LeChatduCheshire/Underwater_swarm_project/hardware/drafts/hardware_draft_2.jpeg

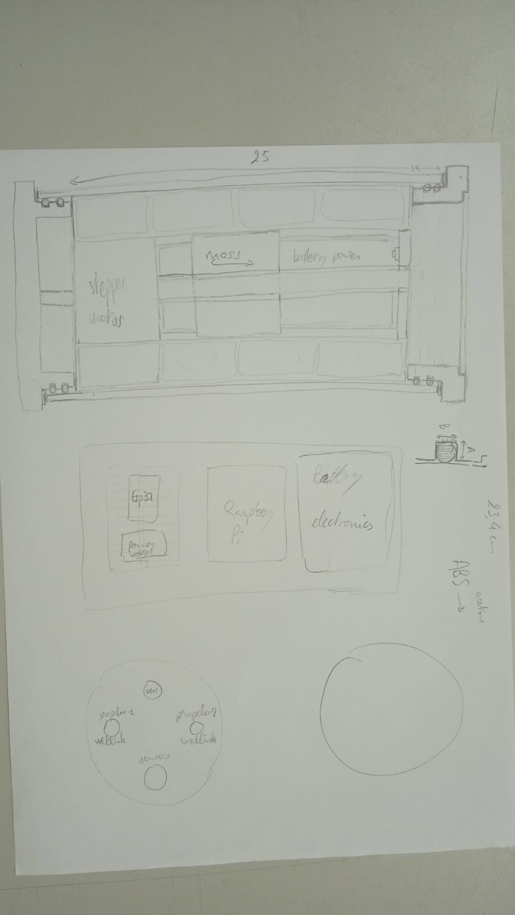
hardware/drafts/hardware_draft_2.jpeg
