LeChatduCheshire/Underwater_swarm_project/hardware/CAD_underwater_swarm_project/stepper_motor_42x48mm/Stepper motor .png

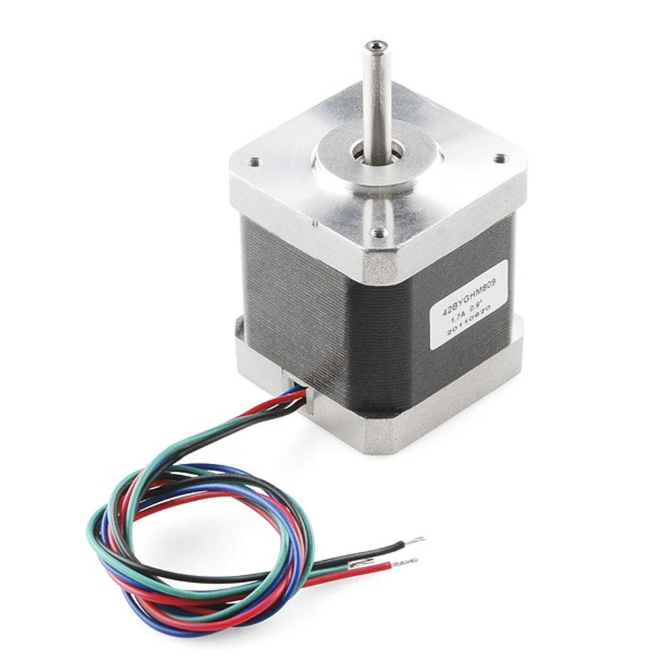
hardware/CAD_underwater_swarm_project/stepper_motor_42x48mm/Stepper motor .png
