LeChatduCheshire/Underwater_swarm_project/README.md

Here are some things to get started with. No rush at all, these are just things to look at over the next couple of weeks.

🎯 Scope
The multi-vehicle formation simulation is part of my ongoing research and upcoming papers, so for this project I'd like us to focus mainly on the real hardware side, building a low-cost ROV and validating it through real-world experiments.

📄 Resources
- My RASSE 2026 and CACS 2026 papers (attached), to understand the background of the project
- ArduSub documentation and ArduPilot SITL docs

🛠 Two things to think about
1. ROV design (especially Thomas, and anyone with mechanical experience)
Could you think about an ROV design that we could realistically build by early November? PVC or 3D printing, either is fine. I'm bringing the thrusters, battery, and electronics, and I'll show you all the parts when I arrive.

2. Research topic (everyone)
Let's think together about a research topic where we can build the ROV and run some experiments by November, and write it up as a paper by your presentation in December. Some examples:
- Design and experimental validation of a low-cost ROV testbed (localization accuracy, position control performance, cost)
- Robust localization for a low-cost ROV, e.g. overhead camera + markers fused with IMU and depth sensor
- System identification of a low-cost ROV to reduce the sim-to-real gap in ArduSub SITL
These are just examples, so feel free to suggest your own ideas!

📅 My schedule
I'll be away from Taiwan from Nov 7 to around Dec 5 for a presentation in Tokyo, the RASSE conference in Chengdu, and an exhibition in Tokyo. I'll be available online by text during that time, so it would be great if we could build the first ROV and do a first pool test before Nov 7.

Also, could you tell me the deadlines for the planning paper, the final paper, and the final presentation (if any)?

💬 By the way, I'm thinking of setting up a Discord server to keep things organized. Would that work for everyone?

When I arrive on October 5, let's meet up, look at the actual parts together, and decide the next steps!
