LeChatduCheshire/Underwater_swarm_project/hardware/Comparring designs.docx

Comparing designs

The general specifications that were followed during the design process of the robot were:

- Robustness against wear
- Watertightness to about 10m
- Unmountability
- Reproductivity without too much adjustment between the different robots
  - This implies that the design must be cheap, to have the budget to make the whole swarm using the same design.

The main differences in price between the safe and the cheap designs come from the hardware, not from the electronics.

The main point is the waterproof hull. Waterproofing is one of the difficult challenges that arise when designing an underwater robot. To function optimally, the joints of the lids must be compressed between grooves of precise dimensions, against an exterior hull which sits at a precise gap of the lid. This requires either precise machining, or a certain amount of work to get the right fitting. The advantage of buying an already-made Bluerobotics hull is that is already done for us, and each product has guaranteed depth resistance of more than 100 meters. For a swarm prototype intended to go to 1- or 2-meters max, these depth limits are completely overkill. The other advantage of using a Bluerobotics hull, is that it is widely used in open-source designs.

Having our own 3D printed design would need more work to get the fitting right for the joints (acetone to get the parts smooth, maybe resin, I am not sure yet). However, I believe that most of the tests and iterations to get the adjustment process right would be done only for the first robot, and then that process would simply be copied for the rest of the swarm. For the whole swarm, it would be a lot cheaper than the bluerobotics option.

Other differences:

Bluerobotics depth sensor vs our depth sensor: The depth sensor we currently have is not waterproof. We need to seal it in epoxy resin in one of the 3D printed part of the robot to allow it to work underwater. This would need to rebuild the support part and rebuy a sensor of something goes wrong, but overall it’s way cheaper than the depth sensor from bluerobotics which is already in a waterproof case.

Vaccum pump: I don’t think having an official model is useful, we can just get a cheap one and an adapter.

Cable penetrators: I think the cheap cable glands are enough for our setting.

For our current project a Raspberry pi 3b will be enough because we don’t have on-board image computing. For Taka’s future projects, he will probably have to upgrade to more recent models.

My conclusion:

If you want to buy the expensive parts for one robot, you have to be ready to do the same for three or four other ones. I would recommend iterating on a low-cost design to make it robust during our project so that the future steps of the swarm project is more accessible.

Comparison of the Two Designs

The robot was designed around the following requirements:

- Resistance to wear and repeated handling.

- Watertightness to approximately 10 meters, although initial experiments will take place at depths of only 1–2 meters.

- Easy disassembly for maintenance and component replacement.

- Reproducibility, with minimal adjustment between individual robots.

- A sufficiently low cost to build an entire swarm using the same design.

The main cost differences between the Safe and Low-cost designs concern the mechanical hardware rather than the electronics.

My Recommendation:

The purchasing decision should be made at the scale of the entire swarm. Choosing expensive components for the first robot implies being prepared to purchase the same components for another three or four robots.

I therefore recommend developing and iterating on the Low-cost design during the current project, with particular attention to sealing reliability, durability and reproducibility. This would require more initial development work, but it should make the next stages of the swarm project more affordable and easier to expand.

Details:

Watertight Enclosure

The enclosure is the most significant difference between the two options. Achieving reliable watertightness is one of the main challenges in underwater robot design. The O-ring grooves, mating surfaces and clearances must be accurately dimensioned to ensure consistent seal compression. This requires either precise manufacturing or additional finishing and adjustment.

A ready-made Blue Robotics enclosure largely removes this development work. Its depth rating depends on the selected configuration, but the available ratings substantially exceed our initial operating depth. Another advantage is that Blue Robotics enclosures are widely used in open-source underwater robotics projects, providing useful design references.

Developing our own enclosure with 3D-printed components would require more work to achieve reliable sealing. Possible finishing methods include acetone smoothing for ABS parts and resin coatings, although the exact process remains to be determined and tested.

I expect most of the development effort to be concentrated on the first prototype. Once the geometry and manufacturing process have been validated, they could be reproduced for the remaining robots. Some individual inspection and adjustment would still be necessary, but this approach should significantly reduce the cost of the complete swarm.

Other Differences

Depth sensor. The sensor we already have is not supplied as a waterproof assembly. We would need to waterproof its electronics and integrate it into a sealed, 3D-printed mount while keeping the pressure-sensing interface functional. Epoxy encapsulation is one possible approach. A failure could require replacing both the sensor and its mount, but the overall cost would remain substantially lower than purchasing a ready-made Blue Robotics depth sensor.

Vacuum pump. I do not see a strong reason to purchase the Blue Robotics pump specifically. A lower-cost manual vacuum pump with a suitable gauge and adapter should be sufficient for our leak tests.

Cable penetrators. Standard cable glands appear to be a reasonable low-cost option for our experimental setting, provided their sealing performance is validated at the intended operating depth.

Onboard computer. A Raspberry Pi 3B should be sufficient for the current project because we do not plan to process images onboard. Taka’s future projects may require a more recent model, depending on their computational requirements.
