LeChatduCheshire/Underwater_swarm_project/hardware/CAD_underwater_swarm_project/underactuated_ROV_technical_drawing_(work_in_progress).png

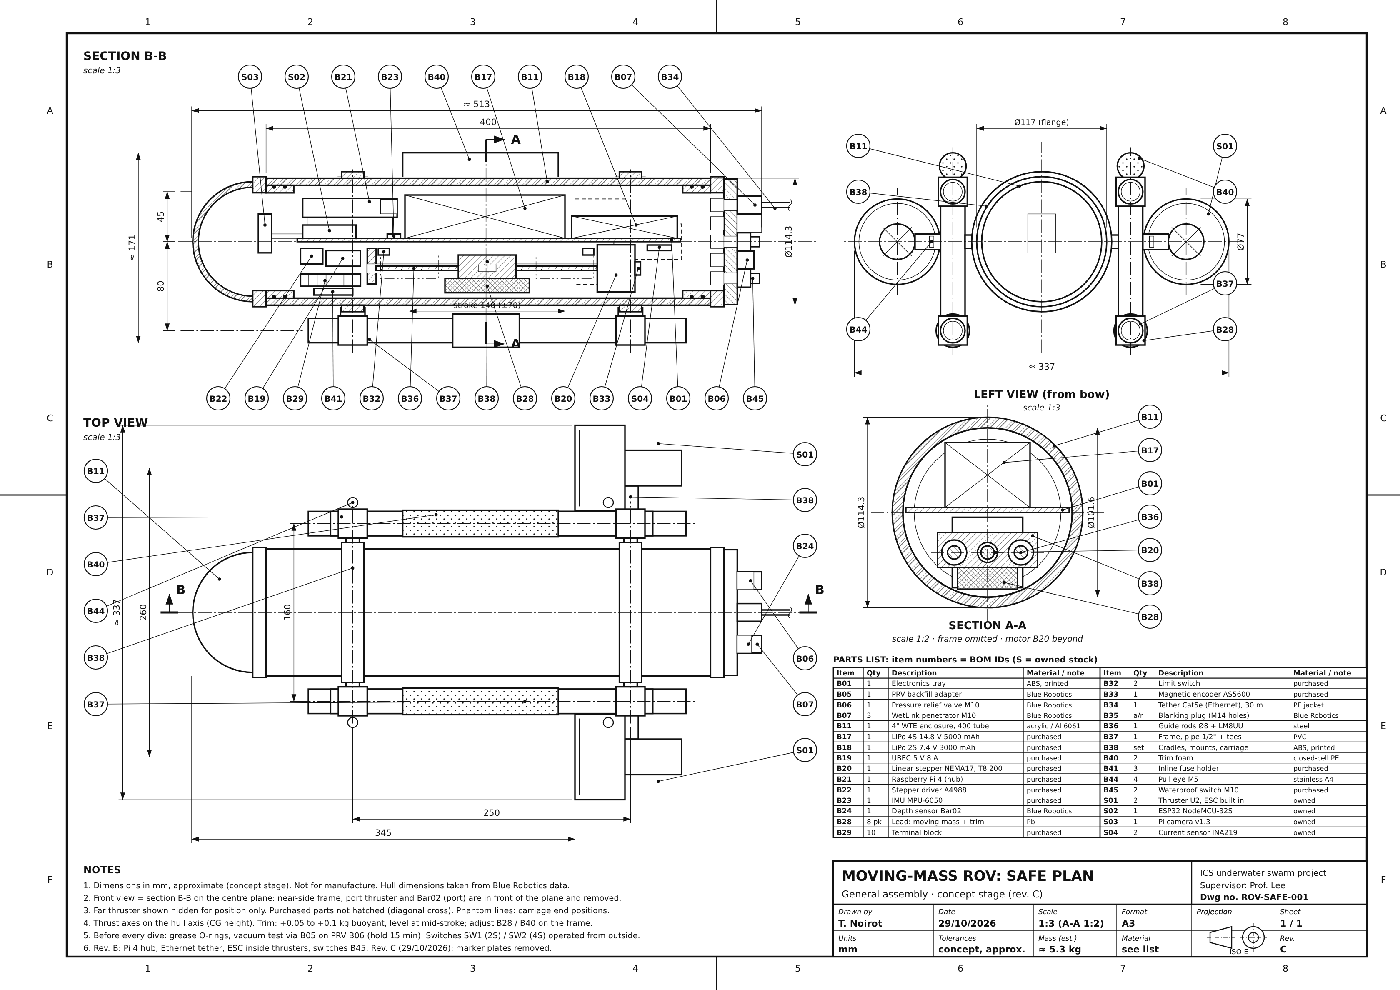
hardware/CAD_underwater_swarm_project/underactuated_ROV_technical_drawing_(work_in_progress).png
