LeChatduCheshire/Underwater_swarm_project/hardware/Doc/stepper_motor_blueprint.png

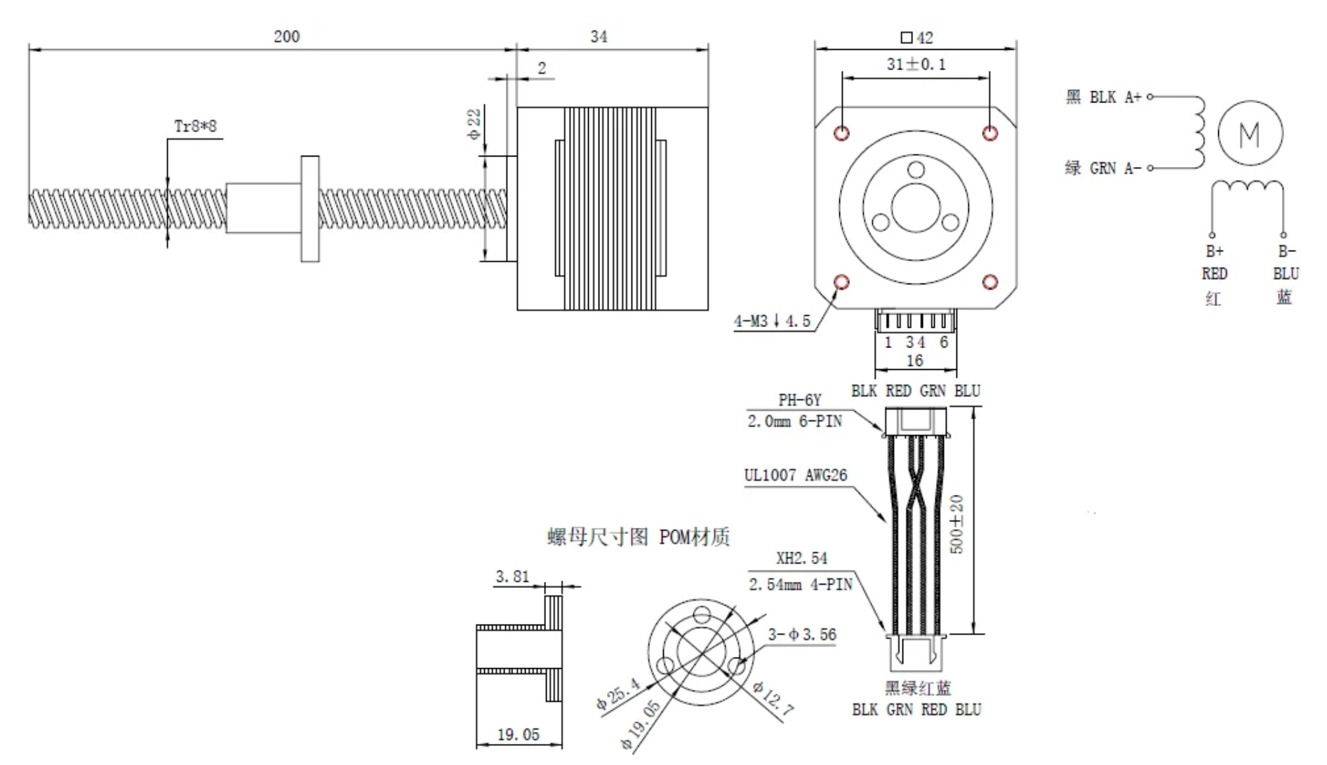
hardware/Doc/stepper_motor_blueprint.png
