LeChatduCheshire/Underwater_swarm_project/hardware/Doc/thruster_blueprint.jpg

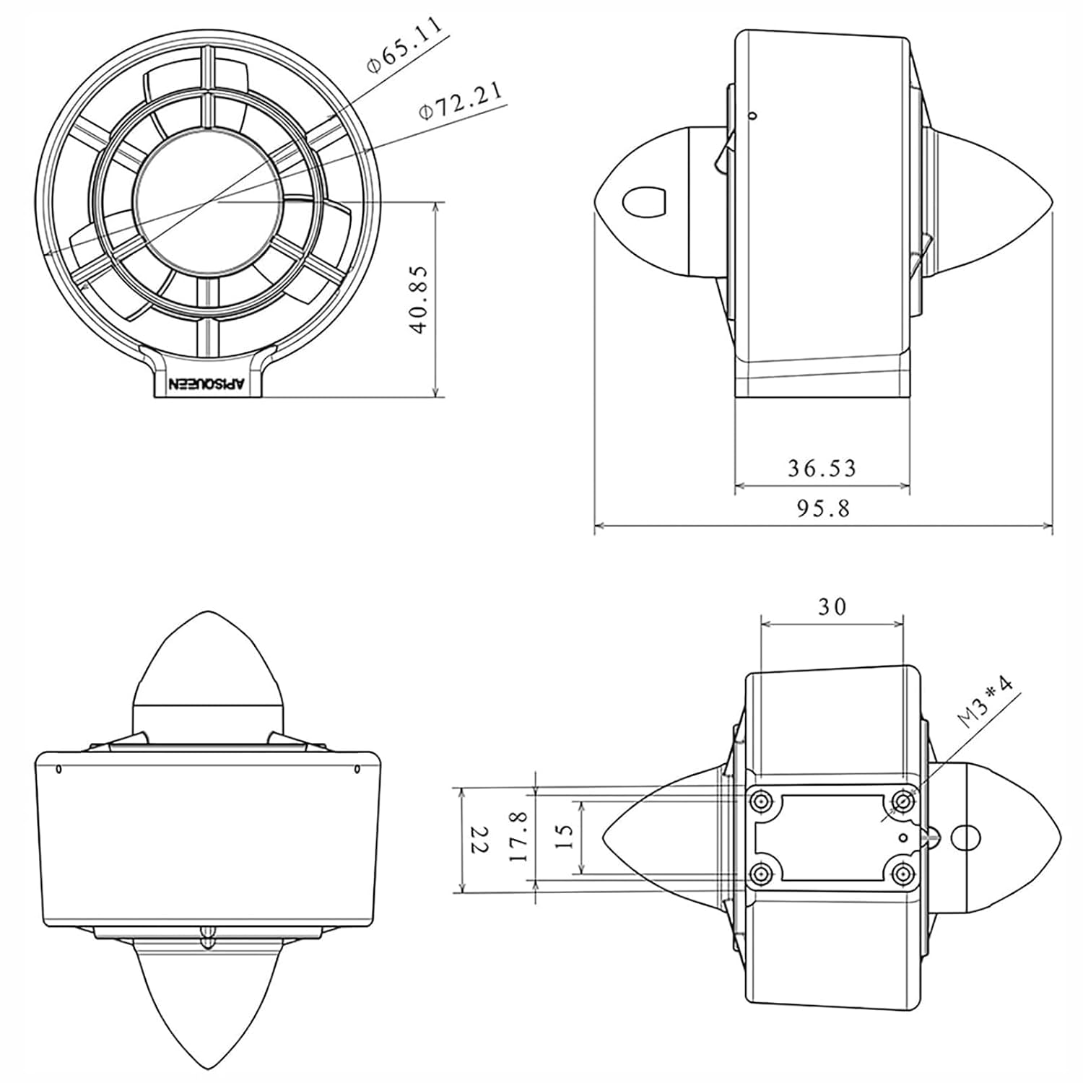
hardware/Doc/thruster_blueprint.jpg
