LeChatduCheshire/Underwater_swarm_project/hardware/drafts/electronics_draft.jpeg

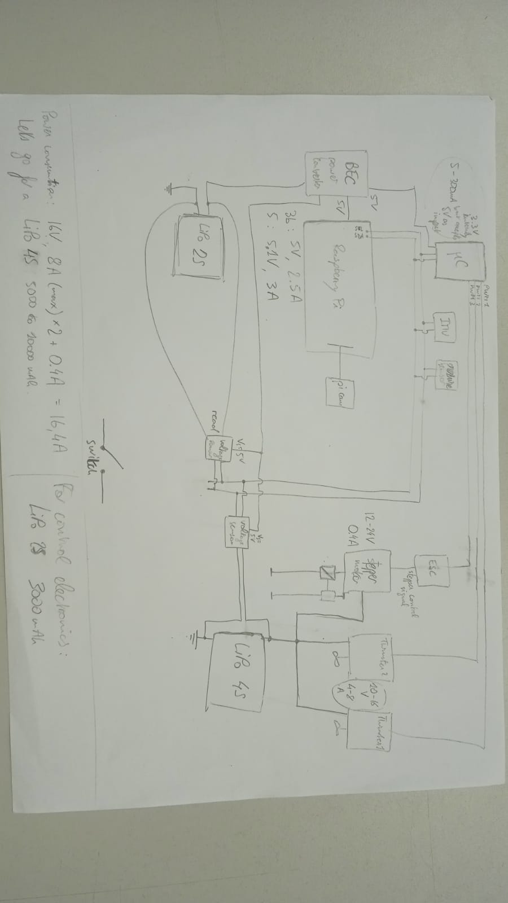
hardware/drafts/electronics_draft.jpeg
