LeChatduCheshire/Underwater_swarm_project/hardware/drafts/hardware_draft_1.jpeg

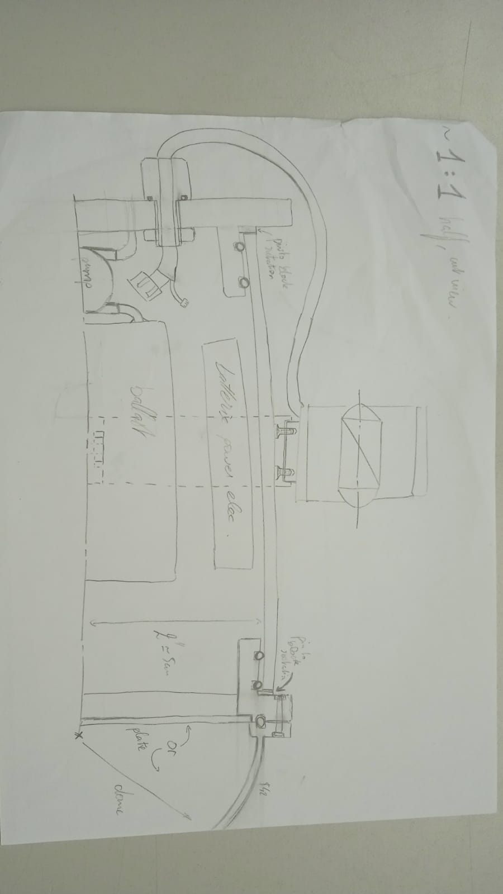
hardware/drafts/hardware_draft_1.jpeg
