LeChatduCheshire/Underwater_swarm_project/hardware/Electronics/underactuated_ROV_electronics_diagram.png

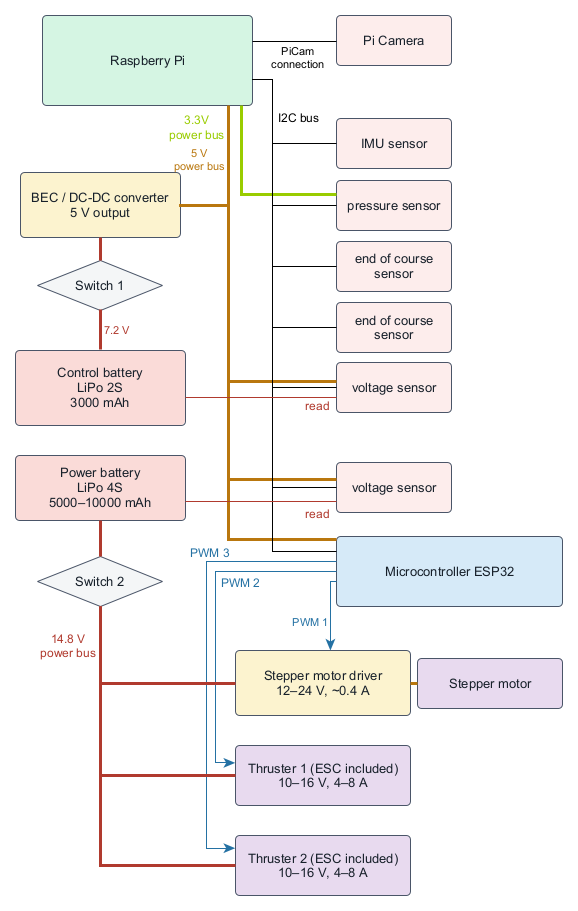
hardware/Electronics/underactuated_ROV_electronics_diagram.png
