LeChatduCheshire/Underwater_swarm_project/hardware/Underwater_Swarm_BOM_TWD_2026.10.19.xlsx

Sheet: Summary
Underwater swarm BOM and purchase tracker
19 October 2026 (Taiwan) | One prototype plus shared tools and consumables | Amounts in TWD
USD to TWD | Reference rate | 32.334 | 18 Oct reference; bank/card rates may differ.
Option | Robot items | Shared items | Budget total | Spent | Still to spend
Safe | 28659.82 | 3768.73 | 32428.55 | 1068.00 | 31240.55
Low-cost | 9458.88 | 2545.67 | 12004.55 | 1068.00 | 10816.55
How to use
Open Parts and filter Option to Both plus the design you choose.
Change Bought? from No to Yes. Remaining drops to zero for that line.
Enter Actual paid TWD for a purchased line, or leave blank to use its budget cost.
For a partial purchase, split the line into separate bought/unbought quantities before checking it.
Both options are alternatives. Spent for a common part appears in each option, not as two purchases.
Budget total is the original plan at current inputs. Spent + remaining may differ after actual-price overrides.
No shipping, customs or payment fees are included. Add those to actual paid costs when known.
Prices marked Sheet quote are copied from the updated sheet and have not all been reverified.
Hypotheses identify estimated prices, selected variants, assumed quantities or undefined interfaces.
Print labor and machine access assumed free. A whole ABS spool is included as a cash purchase.
Complete Safe enclosure assumed to include caps, flanges and installed seals. Confirm configuration.
Backfill adapter and epoxy remain conditional. Set their buy quantity to 0 if you omit them.
Excluded existing stock | Quantity | Applies to
Silicone grease | 1 | Both
Mean Well RSP-320-15 supply | 1 | Both
Fuses (required total still TBD) | 2 | Both
Zegtai 1221 switch | 1 | Both
Apisqueen U2-45A thrusters | 4 | Both
Raspberry Pi 3B | 1 | Low-cost
ESP32 NodeMCU-32S | 1 | Both
Pi camera rev 1.3 | 1 | Both
INA219 current sensor | 2 | Both
MS5837 pressure sensor | 1 | Low-cost
Removed red rows: flexible ballast tank (3), ballast pump head (4), DC pump motor (26).
Safe vacuum plug included in pump kit. Safe enclosure components not counted again.
Online source
https://docs.google.com/spreadsheets/d/1nn8rRRaJWsULoW_6BYai7hUYHaue34ss3Joc6yCNnSo/edit?usp=sharing
FX reference
https://exchangeratetool.com/usd-to-twd

Sheet: Parts
Underwater robot purchase BOM
For one prototype. Both = common to either option. Alternative options must not be added together.
Set Bought? to Yes after purchasing the whole line. Enter actual line cost in TWD if it differs. Yellow cells are editable.
ID | Option | Part | Reference / model | Scope | Bought? | Buy qty | Purchase unit | Unit price | Currency | Unit TWD | Budget TWD | Actual paid TWD | Spent TWD | Remaining TWD | Price basis | Source row | Supplier / source URL | Assumptions / notes
B01 | Both | Internal electronics support | Custom 3D print | Robot | No | 1 | assembly | 0.00 | TWD | 0.00 | 0.00 |  | 0.00 | 0.00 | Workshop assumption | BOM row 5 | https://docs.google.com/spreadsheets/d/1nn8rRRaJWsULoW_6BYai7hUYHaue34ss3Joc6yCNnSo/edit?usp=sharing | Source lists zero. Printing labor/machine access assumed free; one shared filament spool budgeted separately.
B02 | Safe | Vacuum pump kit | Blue Robotics Mityvac BR-100297 | Shared | No | 1 | kit | 98.00 | USD | 3168.73 | 3168.73 |  | 0.00 | 3168.73 | Sheet quote | BOM row 6 | https://bluerobotics.com/store/watertight-enclosures/enclosure-tools-supplies/vacuum-pump-kit-r2-rp/ | Includes hose and vacuum plug. One kit for all robots.
B03 | Low-cost | Manual vacuum pump | Ruten 22635510427265 | Shared | No | 1 | kit | 1123.00 | TWD | 1123.00 | 1123.00 |  | 0.00 | 1123.00 | Sheet quote | BOM row 6 | https://www.ruten.com.tw/item/22635510427265/ | Verify hose fit with Blue Robotics plug.
B04 | Low-cost | Vacuum test plug | Blue Robotics BR-101118 | Shared | No | 1 | piece | 8.00 | USD | 258.67 | 258.67 |  | 0.00 | 258.67 | Sheet quote | BOM row 7 | https://bluerobotics.com/store/watertight-enclosures/enclosure-tools-supplies/vacuum-plug/ | Safe option already includes this plug.
B05 | Both | PRV backfill adapter | Blue Robotics BR-100490 | Robot | No | 1 | piece | 13.00 | USD | 420.34 | 420.34 |  | 0.00 | 420.34 | Sheet quote / optional | BOM row 8 | https://bluerobotics.com/store/watertight-enclosures/prv-m10-backfill-adapter/ | Optional but retained as listed. Set quantity to 0 if not wanted.
B06 | Both | Pressure relief valve | Blue Robotics BR-100804 | Robot | No | 1 | piece | 32.00 | USD | 1034.69 | 1034.69 |  | 0.00 | 1034.69 | Sheet quote | BOM row 9 | https://bluerobotics.com/store/watertight-enclosures/enclosure-tools-supplies/prv-m10-asm/ | Blank low-cost alternative interpreted as same common part.
B07 | Safe | Cable penetrators | WetLink WLP-VP; size TBD | Robot | No | 3 | piece | 15.00 | USD | 485.01 | 1455.03 |  | 0.00 | 1455.03 | Hypothesis: range midpoint | BOM row 10 | https://bluerobotics.com/store/cables-connectors/penetrators/wlp-vp/ | 3 minimum from sheet. USD15 midpoint of USD13–17. Select cable diameter and seal size.
B08 | Low-cost | Cable glands | QILIPSU; exact thread/cable size TBD | Robot | No | 1 | 10-pack | 324.23 | TWD | 324.23 | 324.23 |  | 0.00 | 324.23 | Sheet quote | BOM row 10 | https://www.amazon.com/dp/B0F99Q364K | Buy one full pack of 10, not 3/10 of a pack. At least 3 glands needed.
B09 | Low-cost | Waterproof epoxy | Two-part waterproof epoxy; grade TBD | Shared | No | 1 | tube | 350.00 | TWD | 350.00 | 350.00 |  | 0.00 | 350.00 | Hypothesis: range midpoint | BOM row 12 | https://www.amazon.com/dp/B00R2CDVIW | Midpoint of sheet TWD200–500. Conditional on flat panel; set quantity to 0 for dome.
B10 | Low-cost | ABS finishing solvent | Union Chemical UCW-80343 acetone 99.5% | Shared | No | 1 | 500 mL bottle | 214.00 | TWD | 214.00 | 214.00 |  | 0.00 | 214.00 | Web price / size hypothesis | BOM row 13 | https://www.kingtec.com.tw/product/acetone/ | Assume one 500 mL bottle for prototype. ABS finishing does not establish pressure tightness.
B11 | Safe | Complete 4-inch enclosure | Blue Robotics WTE-VP configuration TBD | Robot | No | 1 | assembly | 440.00 | USD | 14226.96 | 14226.96 |  | 0.00 | 14226.96 | Sheet quote / configuration hypothesis | BOM row 14 | https://bluerobotics.com/store/watertight-enclosures/wte-vp/ | Use USD440 from updated sheet. Assume includes tube, both end caps, flanges and installed O-rings. Exact configuration referenced on Discord was not supplied.
B12 | Low-cost | PVC hull tube | MECCANIXITY 4-inch class, approx. 13-inch long | Robot | No | 1 | tube | 596.86 | TWD | 596.86 | 596.86 |  | 0.00 | 596.86 | Sheet quote | BOM row 14 | https://www.amazon.com/dp/B09J14MMVD | Dimensions/wall thickness must match CAD; local pipe may cost less.
B13 | Low-cost | Front end cap | ABS custom 3D print | Robot | No | 1 | piece | 0.00 | TWD | 0.00 | 0.00 |  | 0.00 | 0.00 | Workshop assumption | BOM row 15 | https://docs.google.com/spreadsheets/d/1nn8rRRaJWsULoW_6BYai7hUYHaue34ss3Joc6yCNnSo/edit?usp=sharing | Filament budgeted separately. Labor/machine access assumed free.
B14 | Low-cost | Rear end cap | ABS custom 3D print | Robot | No | 1 | piece | 0.00 | TWD | 0.00 | 0.00 |  | 0.00 | 0.00 | Workshop assumption | BOM row 16 | https://docs.google.com/spreadsheets/d/1nn8rRRaJWsULoW_6BYai7hUYHaue34ss3Joc6yCNnSo/edit?usp=sharing | Filament budgeted separately. Labor/machine access assumed free.
B15 | Low-cost | Enclosure O-ring sets | Blue Robotics spare O-ring set, 4-inch variant TBD | Robot | No | 2 | set | 10.00 | USD | 323.34 | 646.68 |  | 0.00 | 646.68 | Sheet approximate price | BOM row 17 | https://bluerobotics.com/store/watertight-enclosures/locking-series/spare-o-ring-set/ | Two sets as requested in sheet. Confirm actual contents include required rings/spares.
B16 | Low-cost | Watertight junction parts | ABS custom 3D print | Robot | No | 2 | piece | 0.00 | TWD | 0.00 | 0.00 |  | 0.00 | 0.00 | Workshop assumption | BOM row 18 | https://docs.google.com/spreadsheets/d/1nn8rRRaJWsULoW_6BYai7hUYHaue34ss3Joc6yCNnSo/edit?usp=sharing | Geometry TBD. Filament budgeted separately.
B17 | Both | Propulsion battery | GNB 4S 14.8V 5000mAh 60C | Robot | No | 1 | pack | 2490.00 | TWD | 2490.00 | 2490.00 |  | 0.00 | 2490.00 | Hypothesis: variant price | BOM row 19 | https://www.ruten.com.tw/item/22424717617261/ | Listing spans TWD1380–2490 across 2S/3S/4S. Use upper value for 4S; exact variant price/connector must be confirmed.
B18 | Both | Control battery | Yingke 2S 7.4V 3000mAh 5C | Robot | No | 1 | pack | 820.00 | TWD | 820.00 | 820.00 |  | 0.00 | 820.00 | Web price / model hypothesis | BOM row 20 | https://www.ruten.com.tw/item/22538957862265/ | Assumed model for requested capacity. Confirm dimensions, connector and control-side current.
B19 | Both | 5V voltage converter | ZTW UBEC 8A G2 | Robot | No | 1 | piece | 634.00 | TWD | 634.00 | 634.00 |  | 0.00 | 634.00 | Sheet quote / quantity hypothesis | BOM row 22 | https://www.amazon.com/dp/B0CMD126S4 | Assume one converter; source quantity blank. Set output to 5V and verify full control load.
B20 | Both | Moving-weight linear stepper | NEMA17, 34mm stack, 8mm lead, 200mm screw | Robot | No | 1 | assembly | 40.00 | USD | 1293.36 | 1293.36 |  | 0.00 | 1293.36 | Sheet quote | BOM row 25 | https://www.frankhuai.com/nema-17-lead-screw-stepper-motor-34mm-linear | Retained new depth-control mechanism. Nut/carriage/guides and travel stops need CAD confirmation.
B21 | Safe | Single-board computer | Raspberry Pi 4 Model B 4GB | Robot | No | 1 | board | 2500.00 | TWD | 2500.00 | 2500.00 |  | 0.00 | 2500.00 | Hypothesis: model and price | BOM row 28 | https://shop.mirotek.com.tw/shop/200056/ | Choose Pi4 4GB from sheet Pi4/5. TWD2500 planning estimate against local TWD2310–7680 listing; reference seller shows sold out. Low-cost uses owned Pi3B.
B22 | Both | Stepper motor driver | A4988 module / listed HiLetgo pack | Robot | No | 1 | listed pack | 330.72 | TWD | 330.72 | 330.72 |  | 0.00 | 330.72 | Sheet quote / pack hypothesis | BOM row 29 | https://www.amazon.com/dp/B07BND65C8 | Retain full listing price; package count not confirmed. One driver required.
B23 | Both | IMU | MPU-6050 GY-521; 100Y item 95753 | Robot | No | 1 | module | 120.00 | TWD | 120.00 | 120.00 |  | 0.00 | 120.00 | Web price | BOM row 33 | https://www.100y.com.tw/product/95753 | Taiwan retailer lists TWD120; matches required MPU6050.
B24 | Safe | Depth/pressure sensor | Blue Robotics Bar sensor; pressure range TBD | Robot | No | 1 | module | 80.00 | USD | 2586.72 | 2586.72 |  | 0.00 | 2586.72 | Sheet quote | BOM row 34 | https://bluerobotics.com/store/sensors-cameras/sensors/bar-depth-pressure-sensor/ | Low-cost uses existing MS5837. Select pressure range before buying.
B25 | Both | USB to RS485 adapter | USB-RS485; iCShop 368110900069 as benchmark | Robot | Yes | 1 | adapter | 100.00 | TWD | 100.00 | 100.00 |  | 100.00 | 0.00 | Hypothesis: model, quantity, allowance | BOM row 35 | https://www.icshop.com.tw/ms/products/368110900069 | Source names CP2102, which is USB-UART, not RS485. Allow TWD100 for true RS485; TWD39 benchmark listing is sold out. Confirm intended interface.
B26 | Both | Unspecified USB interface | Provisional CP2102 USB-UART; iCShop 368030501364 | Robot | Yes | 1 | adapter | 58.00 | TWD | 58.00 | 58.00 |  | 58.00 | 0.00 | Hypothesis: function and quantity | BOM row 36 | https://www.icshop.com.tw/products/368030501364 | Source says USB to something and links a TI paper, not a product. Placeholder only, not a confirmed requirement. Set quantity 0 if duplicate.
B27 | Both | Wiring and connectors | Prototype wiring lot; gauges/connectors TBD | Robot | Yes | 1 | lot | 250.00 | TWD | 250.00 | 250.00 |  | 250.00 | 0.00 | Hypothesis: lot content and price | BOM row 37 | https://www.ruten.com.tw/item/21729730427431/ | Allow TWD250 for mixed wire/connectors/heat-shrink. Local 18AWG benchmark is TWD13/m. Final propulsion gauge depends on current.
B28 | Both | Lead trim / moving weight | Adhesive lead strips, 2 x 60g per pack | Robot | No | 4 | 120g pack | 40.00 | TWD | 40.00 | 160.00 |  | 0.00 | 160.00 | Hypothesis: required mass | BOM row 38 | https://www.ruten.com.tw/item/21904699547905/ | Assume 480g starting allowance, NOT validated depth-control mass. Retained non-red lead row; trim and moving-weight material only.
B29 | Both | Terminal blocks | Small screw/lever terminal connectors | Robot | Yes | 10 | piece | 6.00 | TWD | 6.00 | 60.00 |  | 60.00 | 0.00 | Hypothesis: type and quantity | BOM row 39 | https://www.goldsafety.com.tw/products/%E6%8E%A5%E7%B7%9A%E7%AB%AF%E5%AD%90-%E5%BF%AB%E9%80%9F%E6%8E%A5%E9%A0%AD | Assume 10 pieces at local TWD6 benchmark. Match current rating and wire size.
B30 | Both | 3D printing material | ONION3D ABS original, 1kg spool | Shared | Yes | 1 | spool | 600.00 | TWD | 600.00 | 600.00 |  | 600.00 | 0.00 | Hypothesis: material requirement | Added estimate | https://www.onion3d.com/products/abs-original | One spool assumed enough for one prototype. Covers printed supports, caps and junctions; avoids treating material as free.
B31 | Both | End of course sensors for the mass shift system | Limit Switches | Robot | No | 2 | piece | 60.00 | TWD | 60.00 | 120.00 |  | 0.00 | 120.00 | Web site | added after | https://www.100y.com.tw/product/72384 | Pack of 2 for 120 TWD
