LeChatduCheshire/Underwater_swarm_project/hardware/Underwater_Swarm_BOM_TWD_2026.10.10.xlsx

Sheet: Cost comparison
Underwater swarm prototype — purchase costs
Price check date | 2026-10-07 |  | Bank of Taiwan spot selling rate, quoted 2026-10-07 16:40 Taipei.
USD to TWD | 31.875 |  | https://rate.bot.com.tw/xrt?Lang=en-US
Fleet size | 1 |  | Fleet size scales new purchases; existing stock is excluded and is not allocated to extra robots.
Design option | Robot low (TWD) | Robot high (TWD) | Shared low (TWD) | Shared high (TWD)
Safe design | 3043.14 | 3298.14 | 3123.75 | 3123.75
Low-cost design | 2414.38 | 2714.38 | 1378.00 | 1378.00
Priced subtotal for fleet | Low (TWD) | High (TWD)
Safe design | 6166.89 | 6421.89
Low-cost design | 3792.38 | 4092.38
These are partial subtotals, not complete robot budgets.
Shipping, import charges and payment FX fees are excluded. USD prices are converted estimates in TWD.
Includes unverified NKP sheet quote, minimum 2 WetLink penetrators and conditional epoxy range.
Excluded existing stock
Item / reference | Available quantity | Exclusion
Silicone grease | 1 | Both options
Mean Well RSP-320-15 | 1 | Both options
Fuses | 2 | Both options; required total unknown
Zegtai switch 1221 | 1 | Both options
Apisqueen U2-45A thrusters | 4 | Both options
Raspberry Pi 3B | 1 | Low-cost option only
ESP32 NodeMCU-32S | 1 | Both options
Raspberry Pi camera rev 1.3 | 1 | Both options
INA219 current sensor modules | 2 | Both options
MS5837 pressure sensor | 1 | Both options
Source workbook
https://docs.google.com/spreadsheets/d/1nn8rRRaJWsULoW_6BYai7hUYHaue34ss3Joc6yCNnSo/edit?gid=2086489133
No new models were invented for unspecified batteries, hull parts, motors, converters or wiring.

Sheet: Safe design
Safe design — purchase BOM
Scope: one prototype + shared equipment. Already-owned components excluded.
Blank low-cost entries use the safe option unless a distinct alternative is listed.
Subtotal excludes sold-out item and unpriced lines. Built parts have no material/labor estimate.
Source row | Subsystem | Item | Reference / model | Scope | Qty | Currency | Unit low | Unit high | Unit low (TWD) | Unit high (TWD) | Line low (TWD) | Line high (TWD) | Price status | Supplier / source URL | Notes
3 | Hardware | Flexible ballast tank | Thunder Tiger PJ6110 | Per robot | 1 | USD | 6.99 | 6.99 | 222.81 | 222.81 |  |  | Sold out / historical | https://shop.thundertiger.com/en-hz/products/thunder-tiger-neptune-sb-1-seawolf-oceanmaster-ballast-tank-pj6110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 | Listed as sold out. Historical price only; excluded from purchasable subtotal.
4 | Hardware | Ballast pump head | Kamoer NKP pump head; listing 1005008777458190 | Per robot | 1 | TWD | 660.00 | 660.00 | 660.00 | 660.00 | 660.00 | 660.00 | Sheet quote, unverified | https://www.aliexpress.com/item/1005008777458190.html?utm_source=chatgpt.com | Sheet quote only, not independently verified. Motor excluded; tubing variant must be selected.
5 | Hardware | Internal electronics support | Not selected | Per robot | 1 | TWD |  |  |  |  |  |  | Build cost not estimated | https://docs.google.com/spreadsheets/d/1nn8rRRaJWsULoW_6BYai7hUYHaue34ss3Joc6yCNnSo/edit?gid=2086489133 | Source budget is zero. Printing materials and labor are uncosted, not assumed free.
6 | Hardware | Hand-operated vacuum pump | Blue Robotics BR-100297 | Shared equipment | 1 | USD | 98.00 | 98.00 | 3123.75 | 3123.75 | 3123.75 | 3123.75 | Verified USD list price | https://bluerobotics.com/store/watertight-enclosures/enclosure-tools-supplies/vacuum-pump-kit-r2-rp/ | Includes hose and vacuum plug. One kit shared across fleet.
7 | Hardware | Vacuum test plug | Blue Robotics BR-101118 | Shared equipment | 0 | USD | 8.00 | 8.00 | 255.00 | 255.00 | 0.00 | 0.00 | Included in pump kit | https://bluerobotics.com/store/watertight-enclosures/enclosure-tools-supplies/vacuum-plug/ | No separate purchase: included in BR-100297 kit.
8 | Hardware | PRV backfill adapter | Blue Robotics BR-100490 | Per robot | 1 | USD | 13.00 | 13.00 | 414.38 | 414.38 | 414.38 | 414.38 | Verified USD list price | https://bluerobotics.com/store/watertight-enclosures/prv-m10-backfill-adapter/ | Optional in source; retained in priced subtotal. Source quantity is one per robot.
9 | Hardware | Pressure relief valve | Blue Robotics BR-100804 | Per robot | 1 | USD | 32.00 | 32.00 | 1020.00 | 1020.00 | 1020.00 | 1020.00 | Verified USD list price | https://bluerobotics.com/store/watertight-enclosures/enclosure-tools-supplies/prv-m10-asm/ | Retained as listed. Low-cost column has no explicit alternative.
10 | Hardware | Cable penetrators | Blue Robotics WLP-VP; size not selected | Per robot | 2 | USD | 13.00 | 17.00 | 414.38 | 541.88 | 828.76 | 1083.76 | Verified product-family range | https://bluerobotics.com/store/cables-connectors/penetrators/wlp-vp/ | Minimum quantity 2 assumed. Exact thread, cable diameter and total penetrator count remain open.
13 | Hardware | Plastic finishing solvent | Official product | Per robot | 1 | TWD |  |  |  |  |  |  | Missing specification / price | https://docs.google.com/spreadsheets/d/1nn8rRRaJWsULoW_6BYai7hUYHaue34ss3Joc6yCNnSo/edit?gid=2086489133 | Exact solvent and print material unspecified.
14 | Hardware | Main tubular hull, 4-inch class | Acrilic tube (BlueRobotics) | Per robot | 1 | TWD |  |  |  |  |  |  | Missing specification / price | https://docs.google.com/spreadsheets/d/1nn8rRRaJWsULoW_6BYai7hUYHaue34ss3Joc6yCNnSo/edit?gid=2086489133 | Length, wall thickness and diameter standard are missing; no exact compatible SKU can be chosen.
15 | Hardware | Front end cap | Not selected | Per robot | 1 | TWD |  |  |  |  |  |  | Missing specification / price | https://docs.google.com/spreadsheets/d/1nn8rRRaJWsULoW_6BYai7hUYHaue34ss3Joc6yCNnSo/edit?gid=2086489133 | End cap geometry, port pattern and enclosure series unspecified.
16 | Hardware | Rear end cap | Not selected | Per robot | 1 | TWD |  |  |  |  |  |  | Missing specification / price | https://docs.google.com/spreadsheets/d/1nn8rRRaJWsULoW_6BYai7hUYHaue34ss3Joc6yCNnSo/edit?gid=2086489133 | End cap geometry, port pattern and enclosure series unspecified.
17 | Hardware | Enclosure O-rings | Not selected | Per robot | 4 | TWD |  |  |  |  |  |  | Missing specification / price | https://docs.google.com/spreadsheets/d/1nn8rRRaJWsULoW_6BYai7hUYHaue34ss3Joc6yCNnSo/edit?gid=2086489133 | At least 4 per robot plus 2 shared spares. Cross-section, diameter and material unspecified.
17 | Hardware | Shared spare enclosure O-rings | Not selected | Shared equipment | 2 | TWD |  |  |  |  |  |  | Missing specification / price | https://docs.google.com/spreadsheets/d/1nn8rRRaJWsULoW_6BYai7hUYHaue34ss3Joc6yCNnSo/edit?gid=2086489133 | Two spare O-rings for the fleet, as stated in source.
18 | Hardware | Watertight junction parts | Not selected | Per robot | 2 | TWD |  |  |  |  |  |  | Missing specification / price | https://docs.google.com/spreadsheets/d/1nn8rRRaJWsULoW_6BYai7hUYHaue34ss3Joc6yCNnSo/edit?gid=2086489133 | Quantity 2 assumed from source; dimensions depend on enclosure design.
19 | Power electronics | Propulsion battery | Not selected | Per robot | 1 | TWD |  |  |  |  |  |  | Missing specification / price | https://docs.google.com/spreadsheets/d/1nn8rRRaJWsULoW_6BYai7hUYHaue34ss3Joc6yCNnSo/edit?gid=2086489133 | Chemistry, cell count, capacity and discharge current unspecified.
20 | Power electronics | Control electronics battery | Not selected | Per robot | 1 | TWD |  |  |  |  |  |  | Missing specification / price | https://docs.google.com/spreadsheets/d/1nn8rRRaJWsULoW_6BYai7hUYHaue34ss3Joc6yCNnSo/edit?gid=2086489133 | A separate battery is listed; no model or electrical requirements provided.
22 | Power electronics | DC voltage converters | Not selected | Per robot |  | TWD |  |  |  |  |  |  | Missing specification / price | https://docs.google.com/spreadsheets/d/1nn8rRRaJWsULoW_6BYai7hUYHaue34ss3Joc6yCNnSo/edit?gid=2086489133 | Input/output voltage, current rating and quantity unspecified.
25 | Power electronics | DC motor for ballast pump | Not selected | Per robot | 1 | TWD |  |  |  |  |  |  | Missing specification / price | https://docs.google.com/spreadsheets/d/1nn8rRRaJWsULoW_6BYai7hUYHaue34ss3Joc6yCNnSo/edit?gid=2086489133 | Motor voltage, shaft and mounting compatibility with NKP head unspecified.
27 | Control Electronics | Single-board computer | Raspberry Pi 4 or 5 | Per robot | 1 | TWD |  |  |  |  |  |  | Missing specification / price | https://docs.google.com/spreadsheets/d/1nn8rRRaJWsULoW_6BYai7hUYHaue34ss3Joc6yCNnSo/edit?gid=2086489133 | Pi 4 or 5 and RAM capacity are not selected. Existing Pi 3B is excluded only from low-cost option.
31 | Control Electronics | Inertial measurement unit | MPU-6050 GY-521 module | Per robot | 1 | TWD | 120.00 | 120.00 | 120.00 | 120.00 | 120.00 | 120.00 | Verified TWD retailer listing | https://robotkingdom.com.tw/product/mpu-6050-imu-6dof-gy-521/ | GY-521 breakout using MPU-6050; Taiwanese retailer listing price verified.
33 | Control Electronics | USB to RS485 adapter | Silicon labs CP2102 | Per robot |  | TWD |  |  |  |  |  |  | Missing specification / price | https://docs.google.com/spreadsheets/d/1nn8rRRaJWsULoW_6BYai7hUYHaue34ss3Joc6yCNnSo/edit?gid=2086489133 | Source names CP2102 but describes RS485. Interface/transceiver requirement and quantity need confirmation.
34 | Control Electronics | USB interface, type unspecified | Not selected | Per robot |  | TWD |  |  |  |  |  |  | Missing specification / price | https://www.ti.com/lit/wp/slla545/slla545.pdf?ts=1791335239863 | Source provides a technical paper rather than a selected purchasable part.
35 | Control Electronics | Electrical wiring | Not selected | Per robot |  | TWD |  |  |  |  |  |  | Missing specification / price | https://docs.google.com/spreadsheets/d/1nn8rRRaJWsULoW_6BYai7hUYHaue34ss3Joc6yCNnSo/edit?gid=2086489133 | Wire gauge, insulation, connectors and lengths unspecified.
36 | Control Electronics | Ballast weights (lead) | Not selected | Per robot |  | TWD |  |  |  |  |  |  | Missing specification / price | https://docs.google.com/spreadsheets/d/1nn8rRRaJWsULoW_6BYai7hUYHaue34ss3Joc6yCNnSo/edit?gid=2086489133 | Quantity and required ballast mass unspecified.
37 | Control Electronics | Terminal blocks | Not selected | Per robot |  | TWD |  |  |  |  |  |  | Missing specification / price | https://docs.google.com/spreadsheets/d/1nn8rRRaJWsULoW_6BYai7hUYHaue34ss3Joc6yCNnSo/edit?gid=2086489133 | Current rating, pole count and quantity unspecified.

Sheet: Low-cost design
Low-cost design — purchase BOM
Scope: one prototype + shared equipment. Already-owned components excluded.
Blank low-cost entries use the safe option unless a distinct alternative is listed.
Subtotal excludes sold-out item and unpriced lines. Built parts have no material/labor estimate.
Source row | Subsystem | Item | Reference / model | Scope | Qty | Currency | Unit low | Unit high | Unit low (TWD) | Unit high (TWD) | Line low (TWD) | Line high (TWD) | Price status | Supplier / source URL | Notes
3 | Hardware | Flexible ballast tank | Thunder Tiger PJ6110 | Per robot | 1 | USD | 6.99 | 6.99 | 222.81 | 222.81 |  |  | Sold out / historical | https://shop.thundertiger.com/en-hz/products/thunder-tiger-neptune-sb-1-seawolf-oceanmaster-ballast-tank-pj6110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 | Listed as sold out. Historical price only; excluded from purchasable subtotal. Common part assumed from safe-design column; low-cost column is blank.
4 | Hardware | Ballast pump head | Kamoer NKP pump head; listing 1005008777458190 | Per robot | 1 | TWD | 660.00 | 660.00 | 660.00 | 660.00 | 660.00 | 660.00 | Sheet quote, unverified | https://www.aliexpress.com/item/1005008777458190.html?utm_source=chatgpt.com | Sheet quote only, not independently verified. Motor excluded; tubing variant must be selected. Common part assumed from safe-design column; low-cost column is blank.
5 | Hardware | Internal electronics support | Not selected | Per robot | 1 | TWD |  |  |  |  |  |  | Build cost not estimated | https://docs.google.com/spreadsheets/d/1nn8rRRaJWsULoW_6BYai7hUYHaue34ss3Joc6yCNnSo/edit?gid=2086489133 | Source budget is zero. Printing materials and labor are uncosted, not assumed free. Common part assumed from safe-design column; low-cost column is blank.
6 | Hardware | Hand-operated vacuum pump | Ruten listing 22635510427265; manual pressure/vacuum pump | Shared equipment | 1 | TWD | 1123.00 | 1123.00 | 1123.00 | 1123.00 | 1123.00 | 1123.00 | Verified TWD list price | https://www.ruten.com.tw/item/22635510427265/ | One pump shared across fleet. Supplier shipping listed separately: TWD 50–100.
7 | Hardware | Vacuum test plug | Blue Robotics BR-101118 | Shared equipment | 1 | USD | 8.00 | 8.00 | 255.00 | 255.00 | 255.00 | 255.00 | Verified USD list price | https://bluerobotics.com/store/watertight-enclosures/enclosure-tools-supplies/vacuum-plug/ | Assumed common adapter for local pump; verify hose fit.
8 | Hardware | PRV backfill adapter | Blue Robotics BR-100490 | Per robot | 1 | USD | 13.00 | 13.00 | 414.38 | 414.38 | 414.38 | 414.38 | Verified USD list price | https://bluerobotics.com/store/watertight-enclosures/prv-m10-backfill-adapter/ | Optional in source; retained in priced subtotal. Source quantity is one per robot. Common part assumed from safe-design column; low-cost column is blank.
9 | Hardware | Pressure relief valve | Blue Robotics BR-100804 | Per robot | 1 | USD | 32.00 | 32.00 | 1020.00 | 1020.00 | 1020.00 | 1020.00 | Verified USD list price | https://bluerobotics.com/store/watertight-enclosures/enclosure-tools-supplies/prv-m10-asm/ | Retained as listed. Low-cost column has no explicit alternative.
10 | Hardware | Cable penetrators | cable glands | Per robot | 2 | TWD |  |  |  |  |  |  | Missing specification / price | https://www.amazon.com/cable-gland/s?k=cable+gland | Minimum quantity 2 assumed. Exact thread, cable diameter and total penetrator count remain open.
12 | Hardware | Epoxy resin | Not selected | Per robot | 1 | TWD | 200.00 | 500.00 | 200.00 | 500.00 | 200.00 | 500.00 | Sheet estimate, conditional | https://www.amazon.com/s?k=two+part+epoxy | Only listed for low-cost design; conditional on flat acrylic panel instead of dome. Range is a sheet estimate, not an exact product quote.
13 | Hardware | Plastic finishing solvent | Acetone or other | Per robot | 1 | TWD |  |  |  |  |  |  | Missing specification / price | https://www.amazon.com/acetone/s?k=acetone | Exact solvent and print material unspecified.
14 | Hardware | Main tubular hull, 4-inch class | PVC pipe | Per robot | 1 | TWD |  |  |  |  |  |  | Missing specification / price | https://www.amazon.com/4-inch-pvc/s?k=4+inch+pvc | Length, wall thickness and diameter standard are missing; no exact compatible SKU can be chosen.
15 | Hardware | Front end cap | Not selected | Per robot | 1 | TWD |  |  |  |  |  |  | Build cost not estimated | https://docs.google.com/spreadsheets/d/1nn8rRRaJWsULoW_6BYai7hUYHaue34ss3Joc6yCNnSo/edit?gid=2086489133 | End cap geometry, port pattern and enclosure series unspecified.
16 | Hardware | Rear end cap | Not selected | Per robot | 1 | TWD |  |  |  |  |  |  | Build cost not estimated | https://docs.google.com/spreadsheets/d/1nn8rRRaJWsULoW_6BYai7hUYHaue34ss3Joc6yCNnSo/edit?gid=2086489133 | End cap geometry, port pattern and enclosure series unspecified.
17 | Hardware | Enclosure O-rings | Not selected | Per robot | 4 | TWD |  |  |  |  |  |  | Missing specification / price | https://docs.google.com/spreadsheets/d/1nn8rRRaJWsULoW_6BYai7hUYHaue34ss3Joc6yCNnSo/edit?gid=2086489133 | At least 4 per robot plus 2 shared spares. Cross-section, diameter and material unspecified.
17 | Hardware | Shared spare enclosure O-rings | Not selected | Shared equipment | 2 | TWD |  |  |  |  |  |  | Missing specification / price | https://docs.google.com/spreadsheets/d/1nn8rRRaJWsULoW_6BYai7hUYHaue34ss3Joc6yCNnSo/edit?gid=2086489133 | Two spare O-rings for the fleet, as stated in source.
18 | Hardware | Watertight junction parts | Not selected | Per robot | 2 | TWD |  |  |  |  |  |  | Build cost not estimated | https://docs.google.com/spreadsheets/d/1nn8rRRaJWsULoW_6BYai7hUYHaue34ss3Joc6yCNnSo/edit?gid=2086489133 | Quantity 2 assumed from source; dimensions depend on enclosure design.
19 | Power electronics | Propulsion battery | Not selected | Per robot | 1 | TWD |  |  |  |  |  |  | Missing specification / price | https://docs.google.com/spreadsheets/d/1nn8rRRaJWsULoW_6BYai7hUYHaue34ss3Joc6yCNnSo/edit?gid=2086489133 | Chemistry, cell count, capacity and discharge current unspecified. Common part assumed from safe-design column; low-cost column is blank.
20 | Power electronics | Control electronics battery | Not selected | Per robot | 1 | TWD |  |  |  |  |  |  | Missing specification / price | https://docs.google.com/spreadsheets/d/1nn8rRRaJWsULoW_6BYai7hUYHaue34ss3Joc6yCNnSo/edit?gid=2086489133 | A separate battery is listed; no model or electrical requirements provided. Common part assumed from safe-design column; low-cost column is blank.
22 | Power electronics | DC voltage converters | Not selected | Per robot |  | TWD |  |  |  |  |  |  | Missing specification / price | https://docs.google.com/spreadsheets/d/1nn8rRRaJWsULoW_6BYai7hUYHaue34ss3Joc6yCNnSo/edit?gid=2086489133 | Input/output voltage, current rating and quantity unspecified. Common part assumed from safe-design column; low-cost column is blank.
25 | Power electronics | DC motor for ballast pump | Not selected | Per robot | 1 | TWD |  |  |  |  |  |  | Missing specification / price | https://docs.google.com/spreadsheets/d/1nn8rRRaJWsULoW_6BYai7hUYHaue34ss3Joc6yCNnSo/edit?gid=2086489133 | Motor voltage, shaft and mounting compatibility with NKP head unspecified. Common part assumed from safe-design column; low-cost column is blank.
31 | Control Electronics | Inertial measurement unit | MPU-6050 GY-521 module | Per robot | 1 | TWD | 120.00 | 120.00 | 120.00 | 120.00 | 120.00 | 120.00 | Verified TWD retailer listing | https://robotkingdom.com.tw/product/mpu-6050-imu-6dof-gy-521/ | GY-521 breakout using MPU-6050; Taiwanese retailer listing price verified. Common part assumed from safe-design column; low-cost column is blank.
33 | Control Electronics | USB to RS485 adapter | Silicon labs CP2102 | Per robot |  | TWD |  |  |  |  |  |  | Missing specification / price | https://docs.google.com/spreadsheets/d/1nn8rRRaJWsULoW_6BYai7hUYHaue34ss3Joc6yCNnSo/edit?gid=2086489133 | Source names CP2102 but describes RS485. Interface/transceiver requirement and quantity need confirmation. Common part assumed from safe-design column; low-cost column is blank.
34 | Control Electronics | USB interface, type unspecified | Not selected | Per robot |  | TWD |  |  |  |  |  |  | Missing specification / price | https://www.ti.com/lit/wp/slla545/slla545.pdf?ts=1791335239863 | Source provides a technical paper rather than a selected purchasable part. Common part assumed from safe-design column; low-cost column is blank.
35 | Control Electronics | Electrical wiring | Not selected | Per robot |  | TWD |  |  |  |  |  |  | Missing specification / price | https://docs.google.com/spreadsheets/d/1nn8rRRaJWsULoW_6BYai7hUYHaue34ss3Joc6yCNnSo/edit?gid=2086489133 | Wire gauge, insulation, connectors and lengths unspecified. Common part assumed from safe-design column; low-cost column is blank.
36 | Control Electronics | Ballast weights (lead) | Not selected | Per robot |  | TWD |  |  |  |  |  |  | Missing specification / price | https://docs.google.com/spreadsheets/d/1nn8rRRaJWsULoW_6BYai7hUYHaue34ss3Joc6yCNnSo/edit?gid=2086489133 | Quantity and required ballast mass unspecified. Common part assumed from safe-design column; low-cost column is blank.
37 | Control Electronics | Terminal blocks | Not selected | Per robot |  | TWD |  |  |  |  |  |  | Missing specification / price | https://docs.google.com/spreadsheets/d/1nn8rRRaJWsULoW_6BYai7hUYHaue34ss3Joc6yCNnSo/edit?gid=2086489133 | Current rating, pole count and quantity unspecified. Common part assumed from safe-design column; low-cost column is blank.
