LeChatduCheshire/Underwater_swarm_project/hardware/Specifications.ods

Sheet: Specifications
Question
What is the propose of the system ?
What is the environment ?
 | size of environment
 | sea or pool
 | obstacles or not
 | visibility
 | depth
budget ?
Necessary mobility ?
 | propulsion method
 | independant degrees of freedom
What tools do we have ?
 | filament 3D printer ?
 | CNC machine ?
 | Laser cutter ?
 | Hand tools ?
 | resin 3D printer ?
 | Chemicals ?

Sheet: BOM
Part of the system | Part description |  | Number needed | Safe design |  |  |  |  | Cheap design
 |  |  |  | Part name | Buy or build | Price | Comment | Link seller | Part name | Buy or build | Price | Comment | Link seller
Hardware | Flexible Ballast tank |  | 1 | Thunder Tiger Neptune SB-1/Seawolf/Oceanmaster Ballast Tank PJ6110 | Buy | 6.99 USD | Sold out, but inspiration for the type of think we are looking for | https://shop.thundertiger.com/en-hz/products/thunder-tiger-neptune-sb-1-seawolf-oceanmaster-ballast-tank-pj6110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
 | Pump for the balast |  | 1 | Kamoer NKP Micro Peristaltic Pump Head with BPT Tubing or Silicone Tube | Buy | 660 TWD | motor not included | https://www.aliexpress.com/item/1005008777458190.html?utm_source=chatgpt.com
 | Interior support structure for all the electronics etc. |  | 1 |  | Build (3D print) | 0 | see CAD design
 | Vacuum pump |  | 1 (but used for all the robots) | Mityvac Hand Operated Vacuum Pump (BlueRobotics) | Buy | 98 USD |  | https://bluerobotics.com/store/watertight-enclosures/enclosure-tools-supplies/vacuum-pump-kit-r2-rp/ |  | Buy | 1123 TWD |  | https://www.ruten.com.tw/item/22635510427265/
 | Vacuum plug |  | 1 (but used for all the robots) | Vaccum Plug (BlueRobotics) | Buy | 8 USD |  | https://bluerobotics.com/store/watertight-enclosures/enclosure-tools-supplies/vacuum-plug/
 | Pressure Relief Valve Backfill Adapter |  | 1 | Pressure Relief Valve Backfill Adapter (BlueRobotics) | Buy | 13 USD | Not mandatory in a V1, but if we have the budget why not | https://bluerobotics.com/store/watertight-enclosures/prv-m10-backfill-adapter/
 | Pressure Relief Valve. Avoids that our robot turns into a bomb |  | 1 | Pressure Relief Valve (BlueRobotics) | Buy | 32 USD |  | https://bluerobotics.com/store/watertight-enclosures/enclosure-tools-supplies/prv-m10-asm/
 | Penetrators |  | ? (at least 2) | WetLink penetrator (BlueRobotics) | Buy | 13-17 USD |  | https://bluerobotics.com/store/cables-connectors/penetrators/wlp-vp/ | cable glands | Buy | cheap af |  | https://www.amazon.com/cable-gland/s?k=cable+gland
 | Silicone grease for lubrification of the joints |  | 1 tube
 | Epoxy resin |  | 1 tube |  |  |  |  |  |  | Buy | 200-500 TWD | only necessary if we choose the plexiglass pannel instead of the dome | https://www.amazon.com/s?k=two+part+epoxy
 | Plastic Solvent, for making the 3D prints waterproof and the joint grooves smooth |  | 1 small bottle | Official product |  |  |  |  | Acetone or other |  |  |  | https://www.amazon.com/acetone/s?k=acetone
 | Main Watertight Enclosure 4 inches | Main Tubular hull 4'' | 1 | Acrilic tube (BlueRobotics) | buy |  |  |  | PVC pipe | buy |  |  | https://www.amazon.com/4-inch-pvc/s?k=4+inch+pvc
 |  | End cap front | 1 |  | buy |  |  |  |  | build | 0
 |  | End cap end | 1 |  | buy |  |  |  |  | build | 0
 |  | Joints | at least 4 (+2 in security shared by all the robots) |  | buy |  |  |  |  | buy
 |  | Watertight junction parts | 2 (depends on design) |  | buy |  |  |  |  | build | 0
Power electronics | Batteries | Battery power electronics | 1
 |  | Battery control electronics | 1
 | Voltage converters ?
 | Thrusters |  | 2 |  | Buy |  | already 4 in stock
Control Electronics | Micro computer |  | 1 | Raspberry Pi 4 or 5 |  |  |  |  | Raspberry Pi 3B | Buy | 0 | 1 in stock
 | Micro controller |  | 1 | ESP32 | Buy |  | already 1 in stock
 | Camera |  | 1
 | Inertial measurement unit (IMU) |  | 1
 | Pressure sensor |  | 1
