LeChatduCheshire/Underwater_swarm_project/hardware/CAD_underwater_swarm_project/external_frame/T200-ASM-CW-THRUSTER-R1.SLDPRT

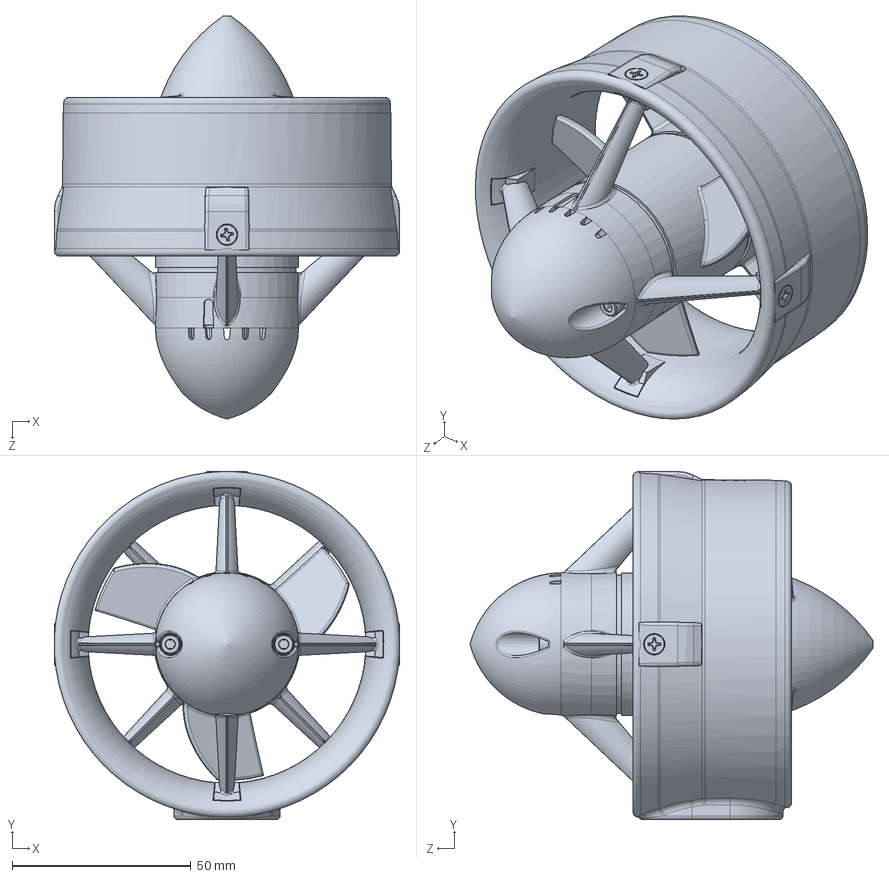
[picture p10: CAD file, 2026-11-06]
hardware/CAD_underwater_swarm_project/external_frame/T200-ASM-CW-THRUSTER-R1.SLDPRT
96.6 x 97.3 x 112.7 mm
