LeChatduCheshire/Underwater_swarm_project/hardware/CAD_underwater_swarm_project/stepper_motor_42x48mm/Steper Motor Nema 17.SLDASM

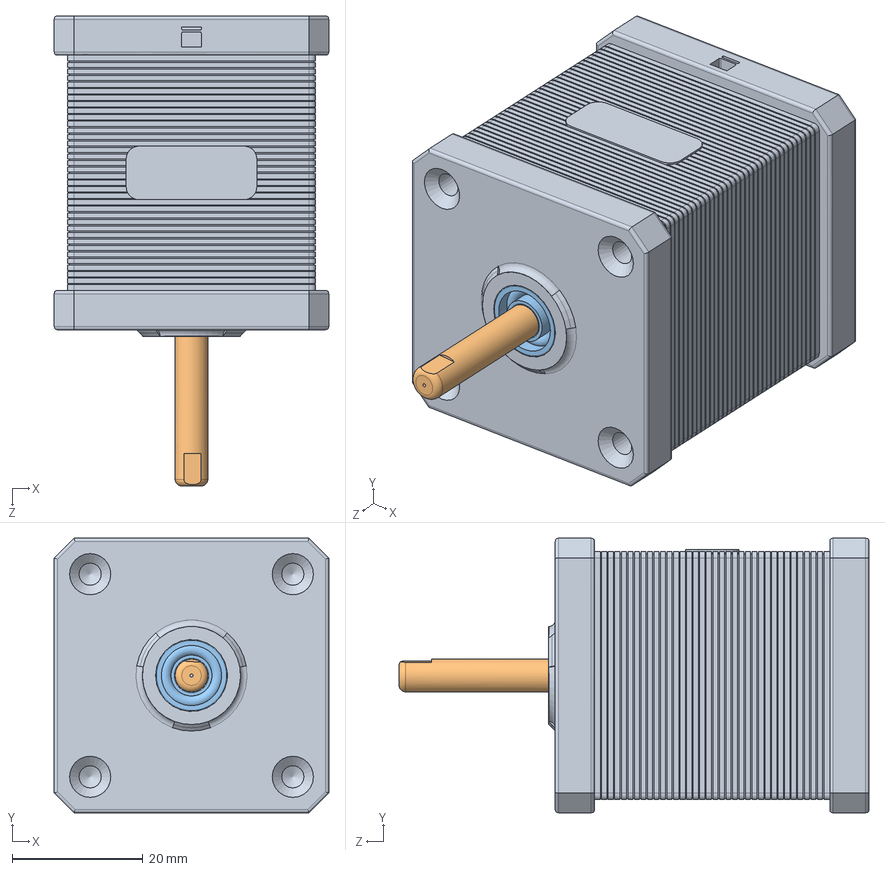
[picture p11: CAD file, 2026-10-27]
hardware/CAD_underwater_swarm_project/stepper_motor_42x48mm/Steper Motor Nema 17.SLDASM
42.0 x 42.0 x 71.9 mm
Stepper Body
Stepper rotor
angular contact ball bearing_68_iso
