LeChatduCheshire/Underwater_swarm_project/hardware/CAD_underwater_swarm_project/electronics/LIMIT_SWITCH_20x6x10.SLDPRT

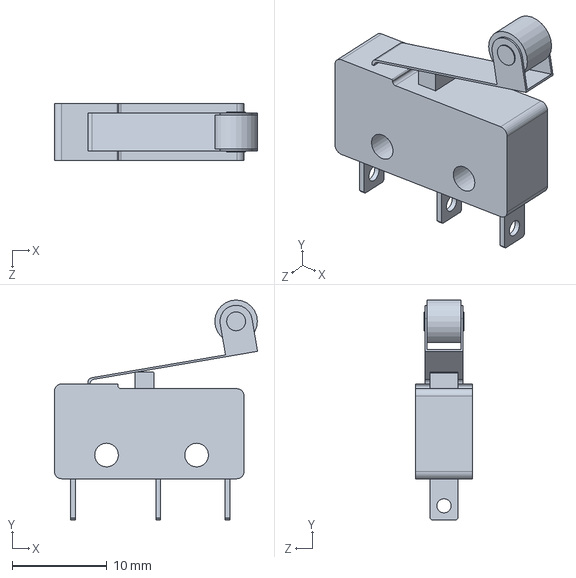
[picture p12: CAD file, 2026-11-06]
hardware/CAD_underwater_swarm_project/electronics/LIMIT_SWITCH_20x6x10.SLDPRT
21.4 x 23.2 x 6.00 mm
