LeChatduCheshire/Underwater_swarm_project/hardware/CAD_underwater_swarm_project/hull/m12-cable-gland-1.snapshot.1/gland_m12.stp

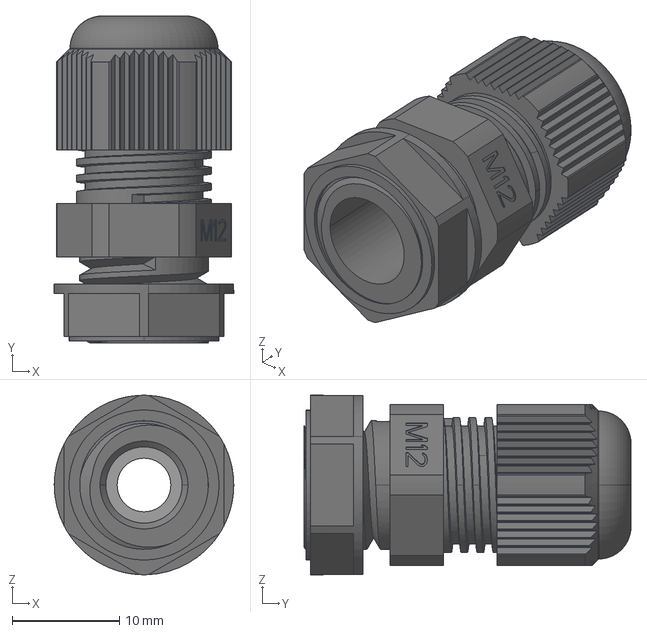
[picture p13: CAD file, 2026-11-06]
hardware/CAD_underwater_swarm_project/hull/m12-cable-gland-1.snapshot.1/gland_m12.stp
16.8 x 30.5 x 16.7 mm
