LeChatduCheshire/Underwater_swarm_project/hardware/watertight enclosure bluerobotics/WTE4-M-FLANGE-SEAL-R3/WTE4-M-FLANGE-SEAL-R3/WTE4-M-FLANGE-SEAL-R3.STEP

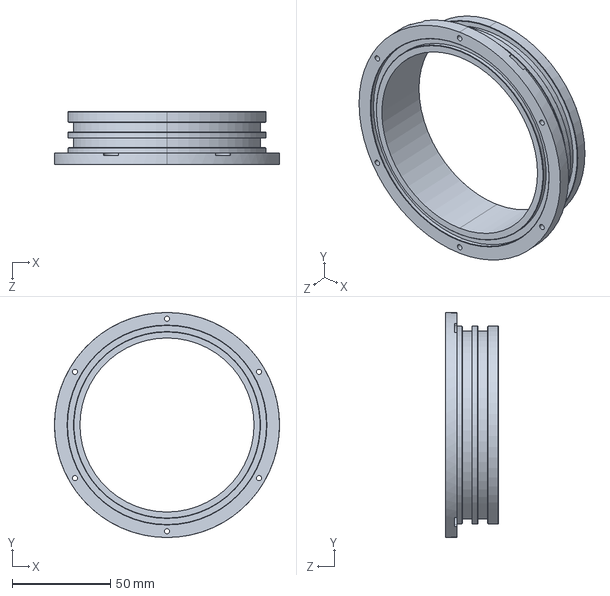
[picture p14: CAD file, 2026-10-06]
hardware/watertight enclosure bluerobotics/WTE4-M-FLANGE-SEAL-R3/WTE4-M-FLANGE-SEAL-R3/WTE4-M-FLANGE-SEAL-R3.STEP
114.3 x 114.3 x 27.0 mm
