LeChatduCheshire/Underwater_swarm_project/hardware/watertight enclosure bluerobotics/WTE4-P-END-CAP-R1/WTE4-P-END-CAP-R1/WTE4-P-END-CAP-R1.STEP

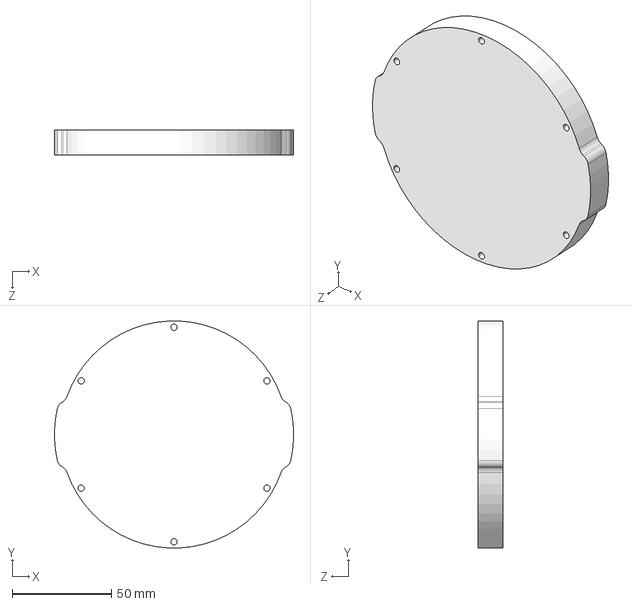
[picture p15: CAD file, 2026-10-06]
hardware/watertight enclosure bluerobotics/WTE4-P-END-CAP-R1/WTE4-P-END-CAP-R1/WTE4-P-END-CAP-R1.STEP
120.2 x 114.1 x 12.7 mm
