LeChatduCheshire/Underwater_swarm_project/hardware/CAD_underwater_swarm_project/stepper_motor_42x48mm/Stepper Body.SLDPRT

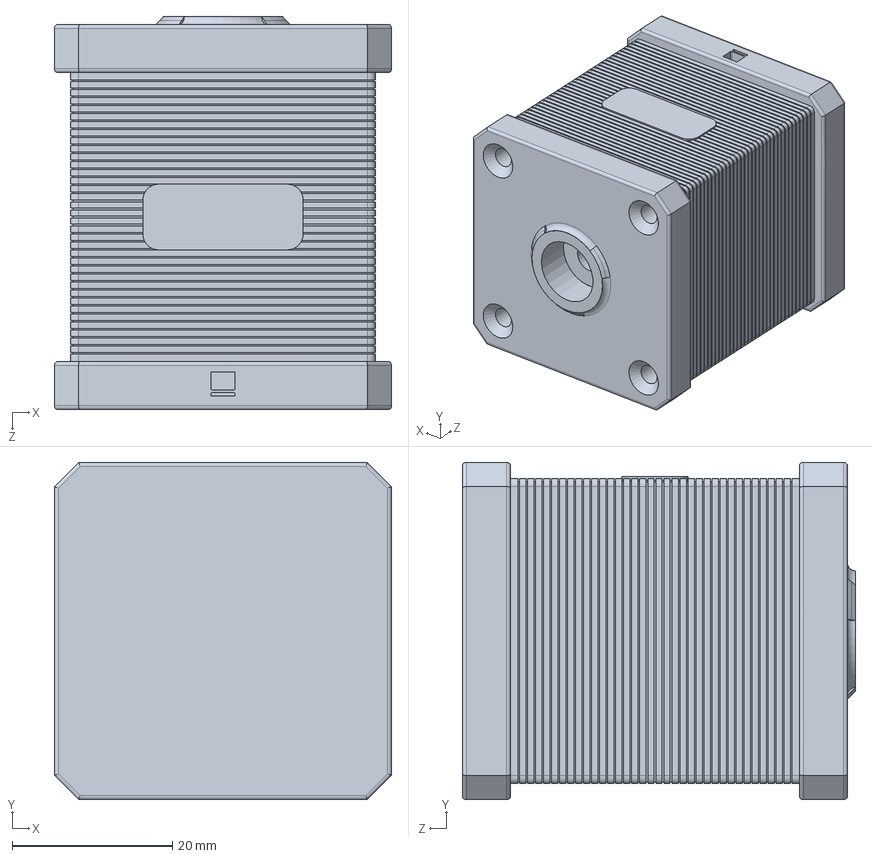
[picture p16: CAD file, 2026-10-27]
hardware/CAD_underwater_swarm_project/stepper_motor_42x48mm/Stepper Body.SLDPRT
42.0 x 42.0 x 49.0 mm
