LeChatduCheshire/Underwater_swarm_project/hardware/watertight enclosure bluerobotics/WTE4-P-TUBE-12-R2/WTE4-P-TUBE-12-R2/WTE4-P-TUBE-12-R2.STEP

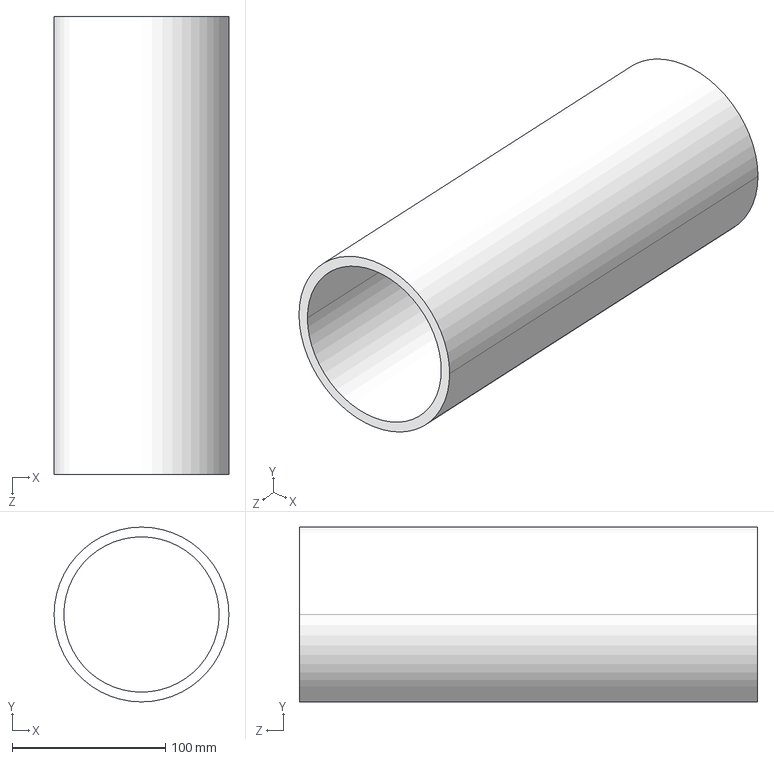
[picture p17: CAD file, 2026-10-06]
hardware/watertight enclosure bluerobotics/WTE4-P-TUBE-12-R2/WTE4-P-TUBE-12-R2/WTE4-P-TUBE-12-R2.STEP
113.9 x 113.9 x 298.4 mm
