LeChatduCheshire/Underwater_swarm_project/hardware/CAD_underwater_swarm_project/stepper_motor_42x48mm/Stepper rotor.SLDPRT

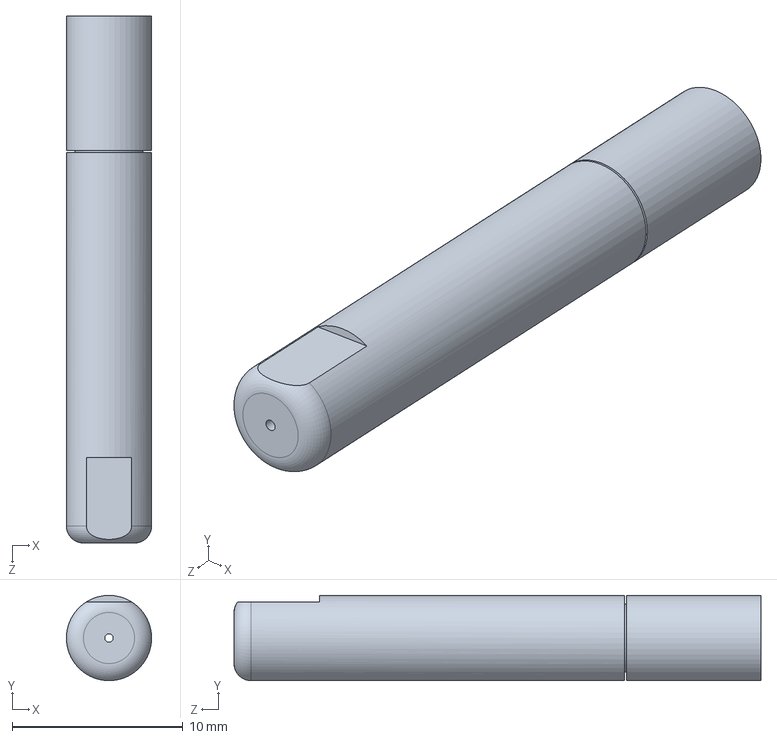
[picture p18: CAD file, 2026-10-27]
hardware/CAD_underwater_swarm_project/stepper_motor_42x48mm/Stepper rotor.SLDPRT
5.00 x 5.00 x 30.9 mm
