LeChatduCheshire/Underwater_swarm_project/(list of files, cad)

Other CAD files:
hardware/watertight enclosure bluerobotics/WTE4-P-TUBE-12-R2/WTE4-P-TUBE-12-R2/Tube.FCStd
hardware/CAD_underwater_swarm_project/OldVersions/WTE4-M-FLANGE-SEAL-R3.0005.ipt
hardware/CAD_underwater_swarm_project/OldVersions/main_hull.0003.ipt
hardware/CAD_underwater_swarm_project/OldVersions/underwater_drone_assembly.0027.iam
hardware/CAD_underwater_swarm_project/WTE4-P-TUBE-12-R2.ipt
hardware/CAD_underwater_swarm_project/batteries/OldVersions/battery_control.0001.ipt
hardware/CAD_underwater_swarm_project/batteries/OldVersions/battery_power.0001.ipt
hardware/CAD_underwater_swarm_project/batteries/battery_control.ipt
hardware/CAD_underwater_swarm_project/batteries/battery_power.ipt
hardware/CAD_underwater_swarm_project/electronics/LIMIT_SWITCH_20x6x10.ipt
hardware/CAD_underwater_swarm_project/electronics/OldVersions/LIMIT_SWITCH_20x6x10.0001.ipt
hardware/CAD_underwater_swarm_project/electronics/Raspberry Pi 3 Light Version.ipt
hardware/CAD_underwater_swarm_project/external_frame/OldVersions/clamp_anterior_superior.0004.ipt
hardware/CAD_underwater_swarm_project/external_frame/OldVersions/depth_sensor_support.0003.ipt
hardware/CAD_underwater_swarm_project/external_frame/OldVersions/handle.0005.ipt
hardware/CAD_underwater_swarm_project/external_frame/OldVersions/stick_2.0003.ipt
hardware/CAD_underwater_swarm_project/external_frame/OldVersions/thruster_adapter_2.0003.ipt
hardware/CAD_underwater_swarm_project/external_frame/T200-ASM-CW-THRUSTER-R1.ipt
hardware/CAD_underwater_swarm_project/external_frame/clamp_anterior_inferior.ipt
hardware/CAD_underwater_swarm_project/external_frame/clamp_anterior_superior.ipt
hardware/CAD_underwater_swarm_project/external_frame/clamp_posterior_inferior.ipt
hardware/CAD_underwater_swarm_project/external_frame/clamp_posterior_superior.ipt
hardware/CAD_underwater_swarm_project/external_frame/depth_sensor_support.ipt
hardware/CAD_underwater_swarm_project/external_frame/handle.ipt
hardware/CAD_underwater_swarm_project/external_frame/rear_clamp_connector.ipt
hardware/CAD_underwater_swarm_project/external_frame/stick.ipt
hardware/CAD_underwater_swarm_project/external_frame/stick_2.ipt
hardware/CAD_underwater_swarm_project/external_frame/thruster_adapter.ipt
hardware/CAD_underwater_swarm_project/external_frame/thruster_adapter_2.ipt
hardware/CAD_underwater_swarm_project/hull/OldVersions/back_lid.0008.ipt
hardware/CAD_underwater_swarm_project/hull/OldVersions/front_lid.0018.ipt
hardware/CAD_underwater_swarm_project/hull/OldVersions/front_window.0001.ipt
hardware/CAD_underwater_swarm_project/hull/OldVersions/main_hull.0004.ipt
hardware/CAD_underwater_swarm_project/hull/back_lid - backup.ipt
hardware/CAD_underwater_swarm_project/hull/back_lid.ipt
hardware/CAD_underwater_swarm_project/hull/front_lid - backup 2.ipt
hardware/CAD_underwater_swarm_project/hull/front_lid - backup.ipt
hardware/CAD_underwater_swarm_project/hull/front_lid.ipt
hardware/CAD_underwater_swarm_project/hull/front_window.ipt
hardware/CAD_underwater_swarm_project/hull/gland_m12.ipt
hardware/CAD_underwater_swarm_project/hull/main_hull.ipt
hardware/CAD_underwater_swarm_project/internal_frame/OldVersions/mass.0001.ipt
hardware/CAD_underwater_swarm_project/internal_frame/OldVersions/stepper_motor_support.0023.ipt
hardware/CAD_underwater_swarm_project/internal_frame/mass.ipt
hardware/CAD_underwater_swarm_project/internal_frame/stepper_motor_support.ipt
hardware/CAD_underwater_swarm_project/main_hull.ipt
hardware/CAD_underwater_swarm_project/stepper_motor_42x34mm/OldVersions/stepper_motor_42x34mm.0002.ipt
hardware/CAD_underwater_swarm_project/stepper_motor_42x34mm/stepper_motor_42x34mm.ipt
hardware/CAD_underwater_swarm_project/underwater_drone_assembly.iam
hardware/watertight enclosure bluerobotics/WTE4-M-FLANGE-SEAL-R3/WTE4-M-FLANGE-SEAL-R3/WTE4-M-FLANGE-SEAL-R3.IGS
hardware/watertight enclosure bluerobotics/WTE4-M-FLANGE-SEAL-R3/WTE4-M-FLANGE-SEAL-R3/WTE4-M-FLANGE-SEAL-R3.SLDPRT
hardware/watertight enclosure bluerobotics/WTE4-M-FLANGE-SEAL-R3/WTE4-M-FLANGE-SEAL-R3/WTE4-M-FLANGE-SEAL-R3.STL
hardware/watertight enclosure bluerobotics/WTE4-P-END-CAP-R1/WTE4-P-END-CAP-R1/WTE4-P-END-CAP-R1.IGS
hardware/watertight enclosure bluerobotics/WTE4-P-END-CAP-R1/WTE4-P-END-CAP-R1/WTE4-P-END-CAP-R1.SLDPRT
hardware/watertight enclosure bluerobotics/WTE4-P-END-CAP-R1/WTE4-P-END-CAP-R1/WTE4-P-END-CAP-R1.STL
hardware/watertight enclosure bluerobotics/WTE4-P-TUBE-12-R2/WTE4-P-TUBE-12-R2/WTE4-P-TUBE-12-R2.IGS
hardware/watertight enclosure bluerobotics/WTE4-P-TUBE-12-R2/WTE4-P-TUBE-12-R2/WTE4-P-TUBE-12-R2.SLDPRT
hardware/watertight enclosure bluerobotics/WTE4-P-TUBE-12-R2/WTE4-P-TUBE-12-R2/WTE4-P-TUBE-12-R2.STL
