LeChatduCheshire/Underwater_swarm_project/(commit log)

2026-10-27 started CAD
    [End_Cap.FCStd]
2026-11-06 first clean version of the CAD
    [LIMIT_SWITCH_20x6x10.0001.ipt, LIMIT_SWITCH_20x6x10.SLDPRT, LIMIT_SWITCH_20x6x10.ipt, Raspberry Pi 3 Light Version.SLDPRT, Raspberry Pi 3 Light Version.ipt, Raspberry Pi 3.SLDPRT, T200-ASM-CW-THRUSTER-R1.SLDPRT, T200-ASM-CW-THRUSTER-R1.ipt]
